Lawrence4U/Irrigation-System-v2/README.md

# Irrigation System using LoRa communications and Chirpstack

### KiCad

The external footprints used can be found in the [Imports](./KiCad/symbols/Imports/) folder.
