Lawrence4U/Irrigation-System-v2/misc/AnemYLuz.md

### Anemometros

+ Aliemntacion 7-24V. Salida de 0.4V(0m/s) a 2V (32.4m/s) con precision 1m/s [link](https://www.digikey.es/es/products/detail/adafruit-industries-llc/1733/5356813?productid=5356813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)

+ info solo que va de 0 a 5V [link](https://www.mouser.es/ProductDetail/DFRobot/SEN0170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)

+ el de sparkFun. Incluye anem, lluvia y dirección de viento pero complejo [link](https://www.mouser.es/ProductDetail/SparkFun/SEN-15901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)

### Sensores de luz

+ Placa de TEMT6000, podriamos montarlo nosotros en placa directo [link](https://www.digikey.es/es/products/detail/sparkfun-electronics/BOB-08688/5140813?productid=5140813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)

+ si lo montamos en la caja con la placa, i2c [link](https://www.digikey.es/es/products/detail/adafruit-industries-llc/5591/16733167?productid=16733167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)

+ Uno muy simplón con salida analógica [link](https://www.digikey.es/es/products/detail/adafruit-industries-llc/2748/5775538?productid=5775538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)

Casi todos los sensores de luz son un sensor montado en una placa por I2C

st1480 422 driver
