Lawrence4U/Irrigation-System-v2/KiCad/symbols/Imports/SimbolosSnapEDA/SOIC28-300.STEP

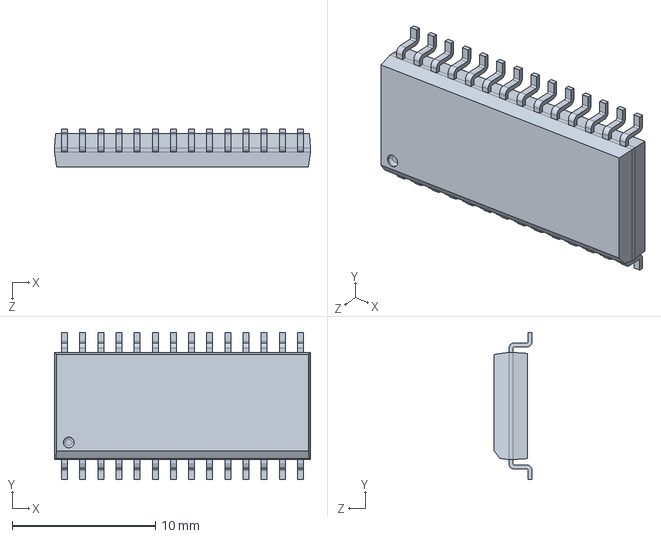
[picture p3: CAD file, 2024-04-19]
KiCad/symbols/Imports/SimbolosSnapEDA/SOIC28-300.STEP
17.9 x 10.3 x 2.65 mm
