Lawrence4U/Irrigation-System-v2/KiCad/symbols/Imports/SimbolosSnapEDA/L298P--3DModel-STEP-56544.STEP

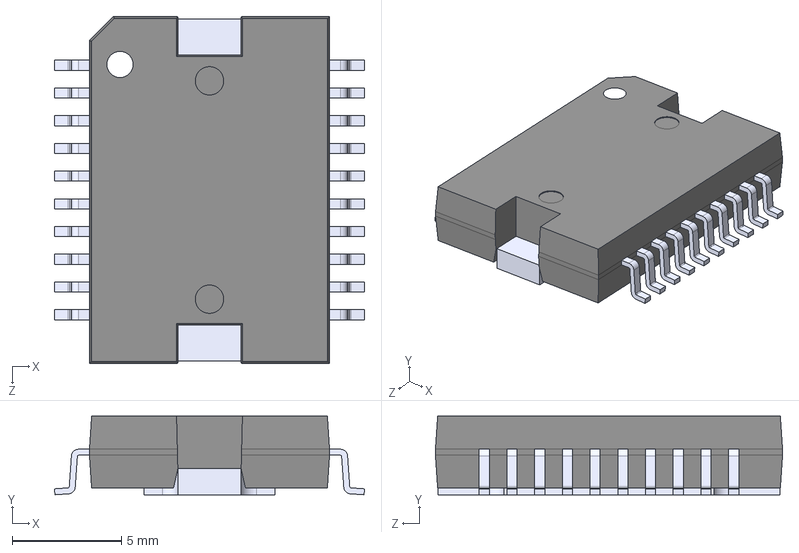
[picture p4: CAD file, 2024-04-19]
KiCad/symbols/Imports/SimbolosSnapEDA/L298P--3DModel-STEP-56544.STEP
14.2 x 3.60 x 15.9 mm
