Lawrence4U/Irrigation-System-v2/KiCad/symbols/Imports/SimbolosSnapEDA/DS89C21TMX_NOPB.STEP

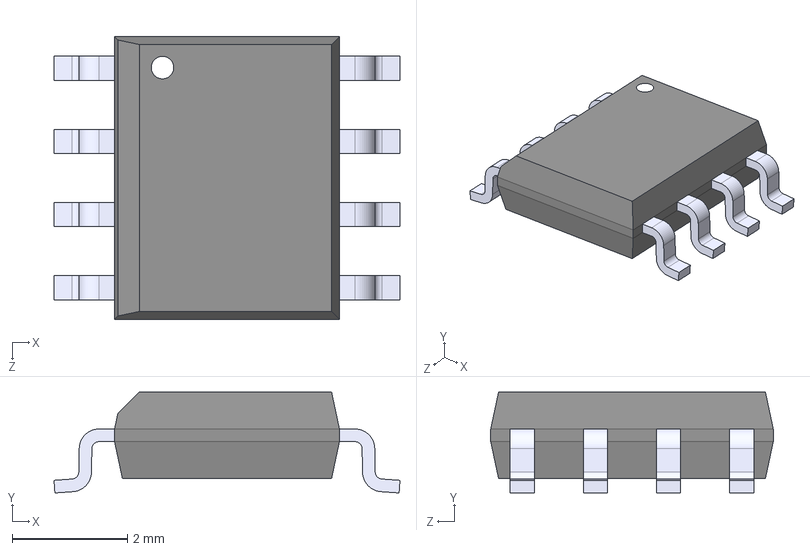
[picture p5: CAD file, 2024-04-16]
KiCad/symbols/Imports/SimbolosSnapEDA/DS89C21TMX_NOPB.STEP
6.00 x 1.75 x 4.90 mm
