Lawrence4U/Irrigation-System-v2/KiCad/symbols/Imports/SimbolosSnapEDA/TMP75AQDGKRQ1.STEP

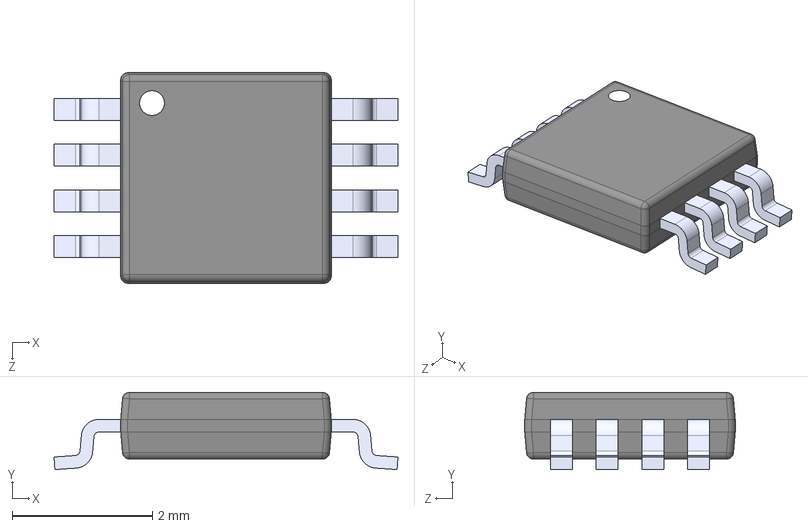
[picture p6: CAD file, 2024-04-16]
KiCad/symbols/Imports/SimbolosSnapEDA/TMP75AQDGKRQ1.STEP
4.90 x 1.10 x 3.00 mm
