Lawrence4U/Irrigation-System-v2/KiCad/3d/691382040006.stp

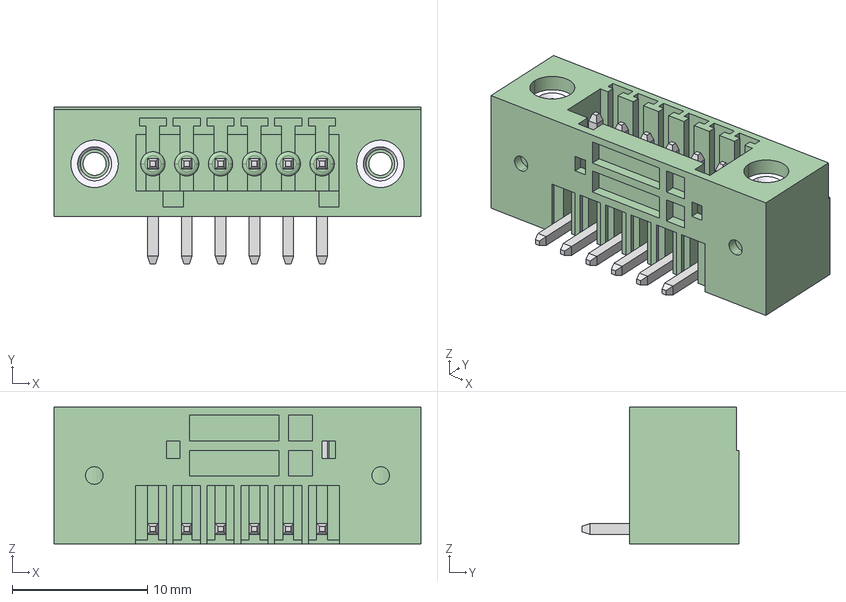
[picture p7: CAD file, 2024-02-01]
KiCad/3d/691382040006.stp
27.1 x 11.6 x 10.1 mm
