Lawrence4U/Irrigation-System-v2/KiCad/symbols/Imports/SimbolosSnapEDA/691382030006.step

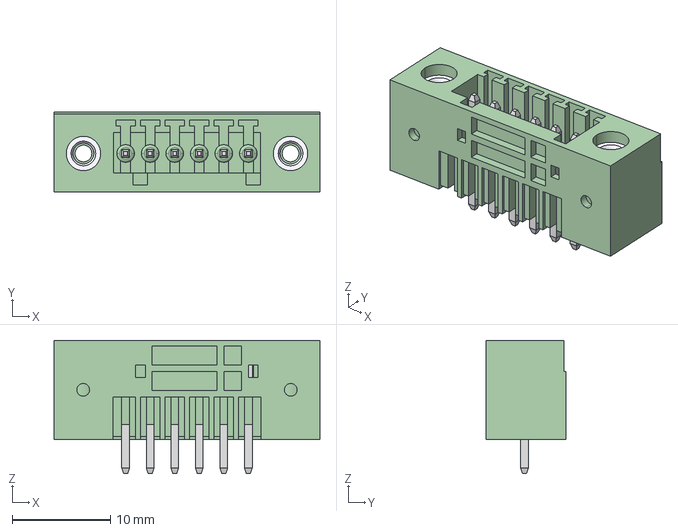
[picture p8: CAD file, 2024-02-10]
KiCad/symbols/Imports/SimbolosSnapEDA/691382030006.step
27.1 x 8.10 x 13.6 mm
