Lawrence4U/Irrigation-System-v2/KiCad/SalveNode/gerbers/SalveNode-F_Silkscreen.pdf

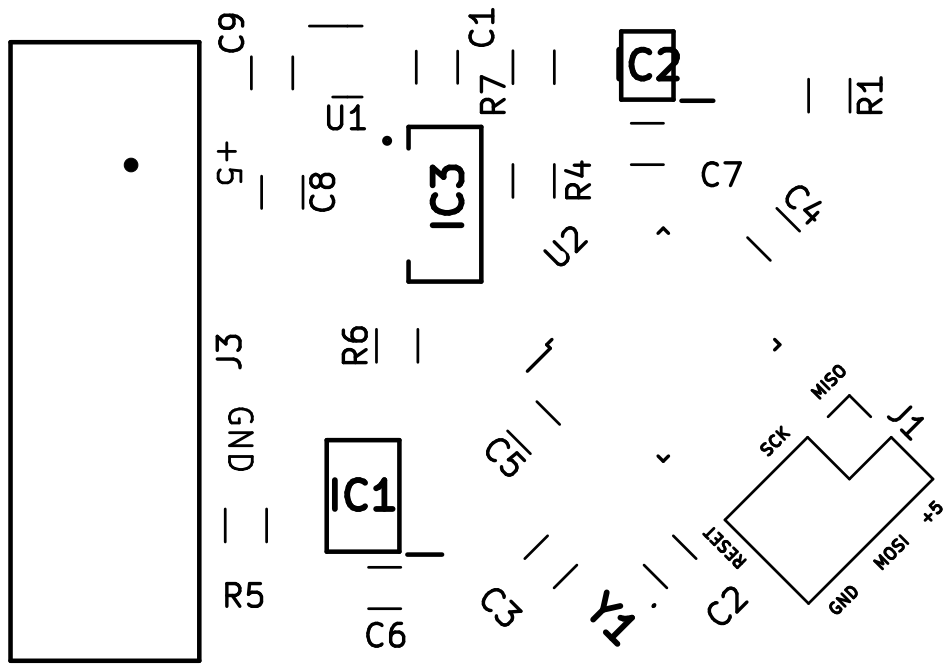
[picture p9: page 1]

SCK GND RESET MOSI +5 +5 GND MISO R5C9C1 J3 Y1 C7 C3 R1 C4 R7 C5 R4 IC2 U2 J1 C8 IC3 C6 U1
