Lawrence4U/Irrigation-System-v2/KiCad/SalveNode/gerbers/SalveNode-B_Cu.pdf

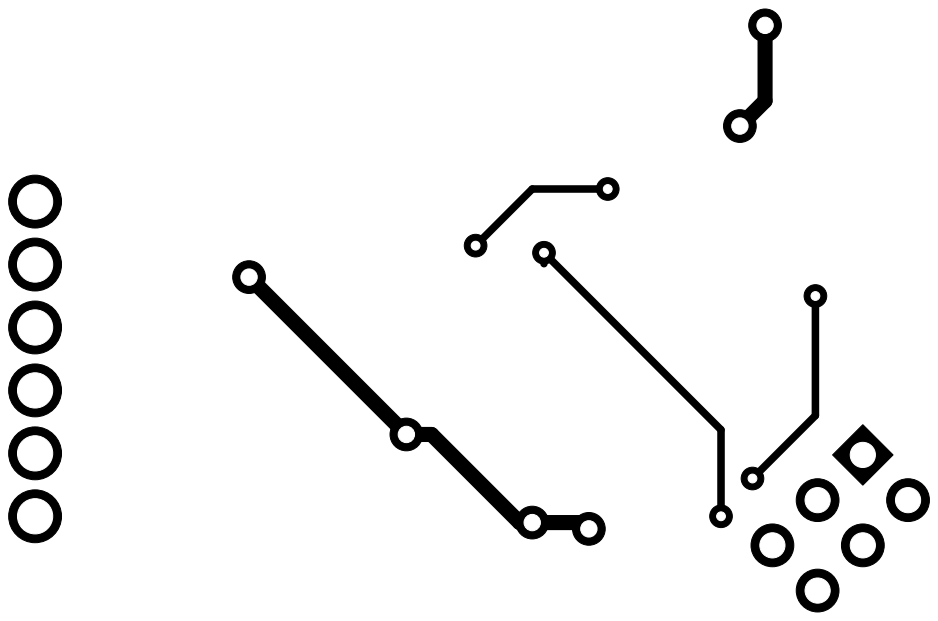
[picture p10: page 1]
