Lawrence4U/Irrigation-System-v2/KiCad/SalveNode/gerbers/SalveNode-B_Mask.pdf

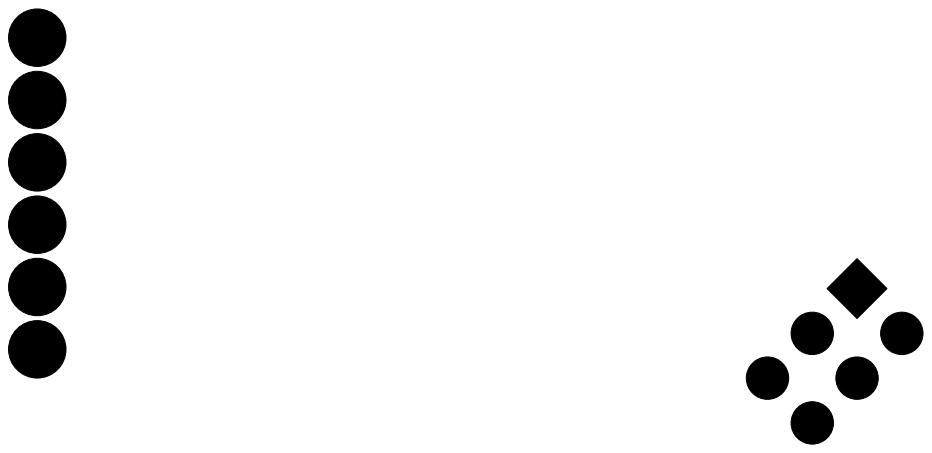
[picture p11: page 1]
