Lawrence4U/Irrigation-System-v2/KiCad/SalveNode/gerbers/SalveNode-F_Cu.pdf

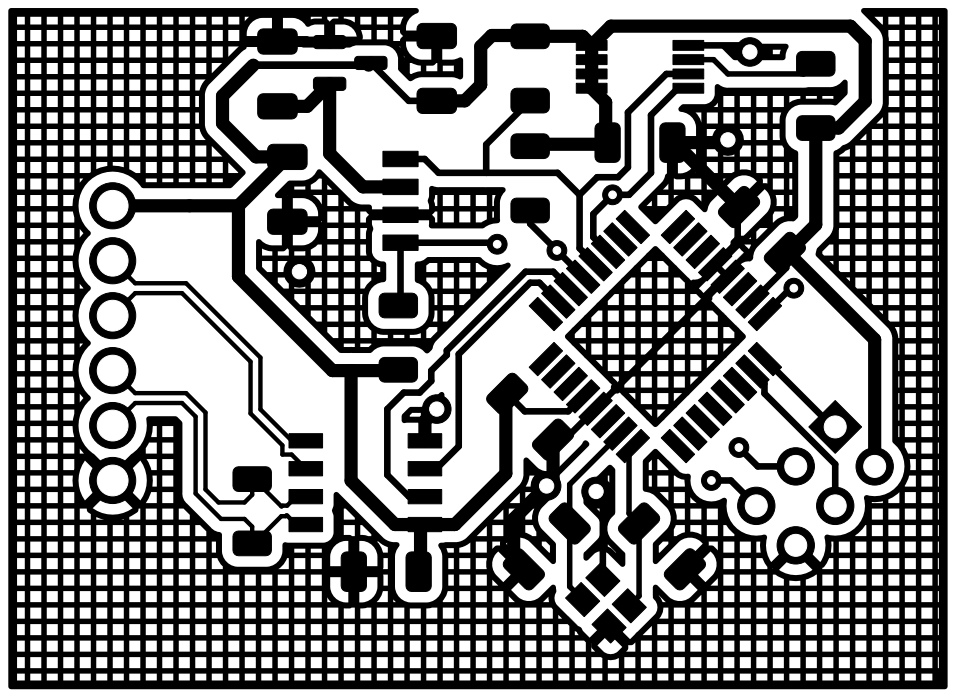
[picture p12: page 1]
