Lawrence4U/Irrigation-System-v2/KiCad/SalveNode/gerbers/SalveNode-F_Mask.pdf

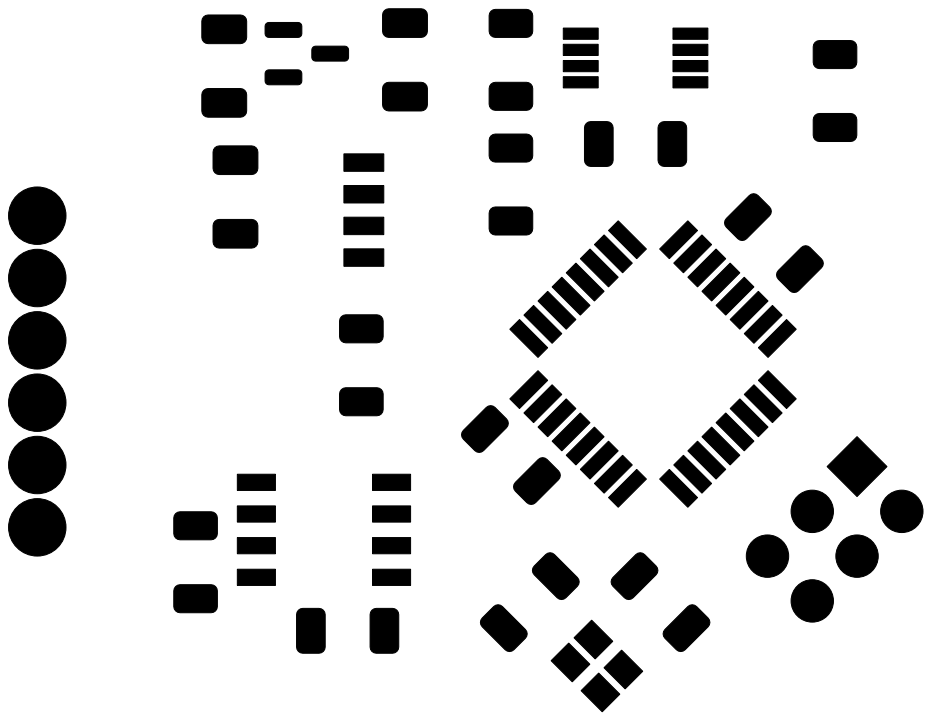
[picture p13: page 1]
