Lawrence4U/Irrigation-System-v2/KiCad/SalveNode/gerbers/SalveNode-F_Paste.pdf

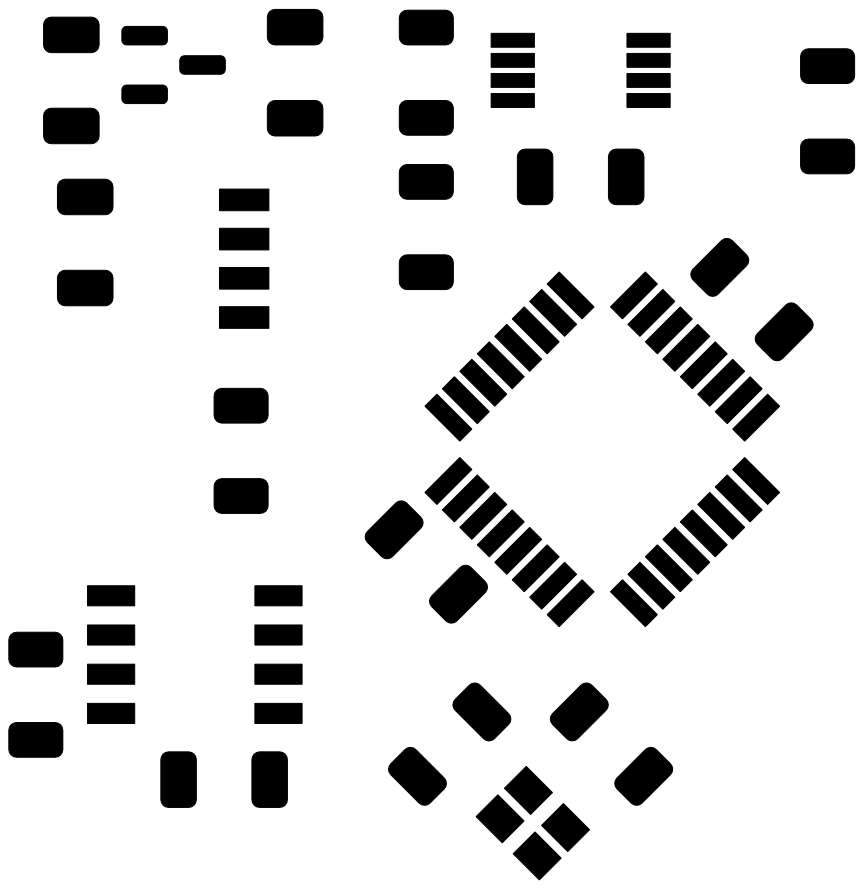
[picture p14: page 1]
