Lawrence4U/Irrigation-System-v2/KiCad/IrrigationController/KiCad.kicad_pcb

## KiCad design KiCad/IrrigationController/KiCad.kicad_pcb (2024-07-01)

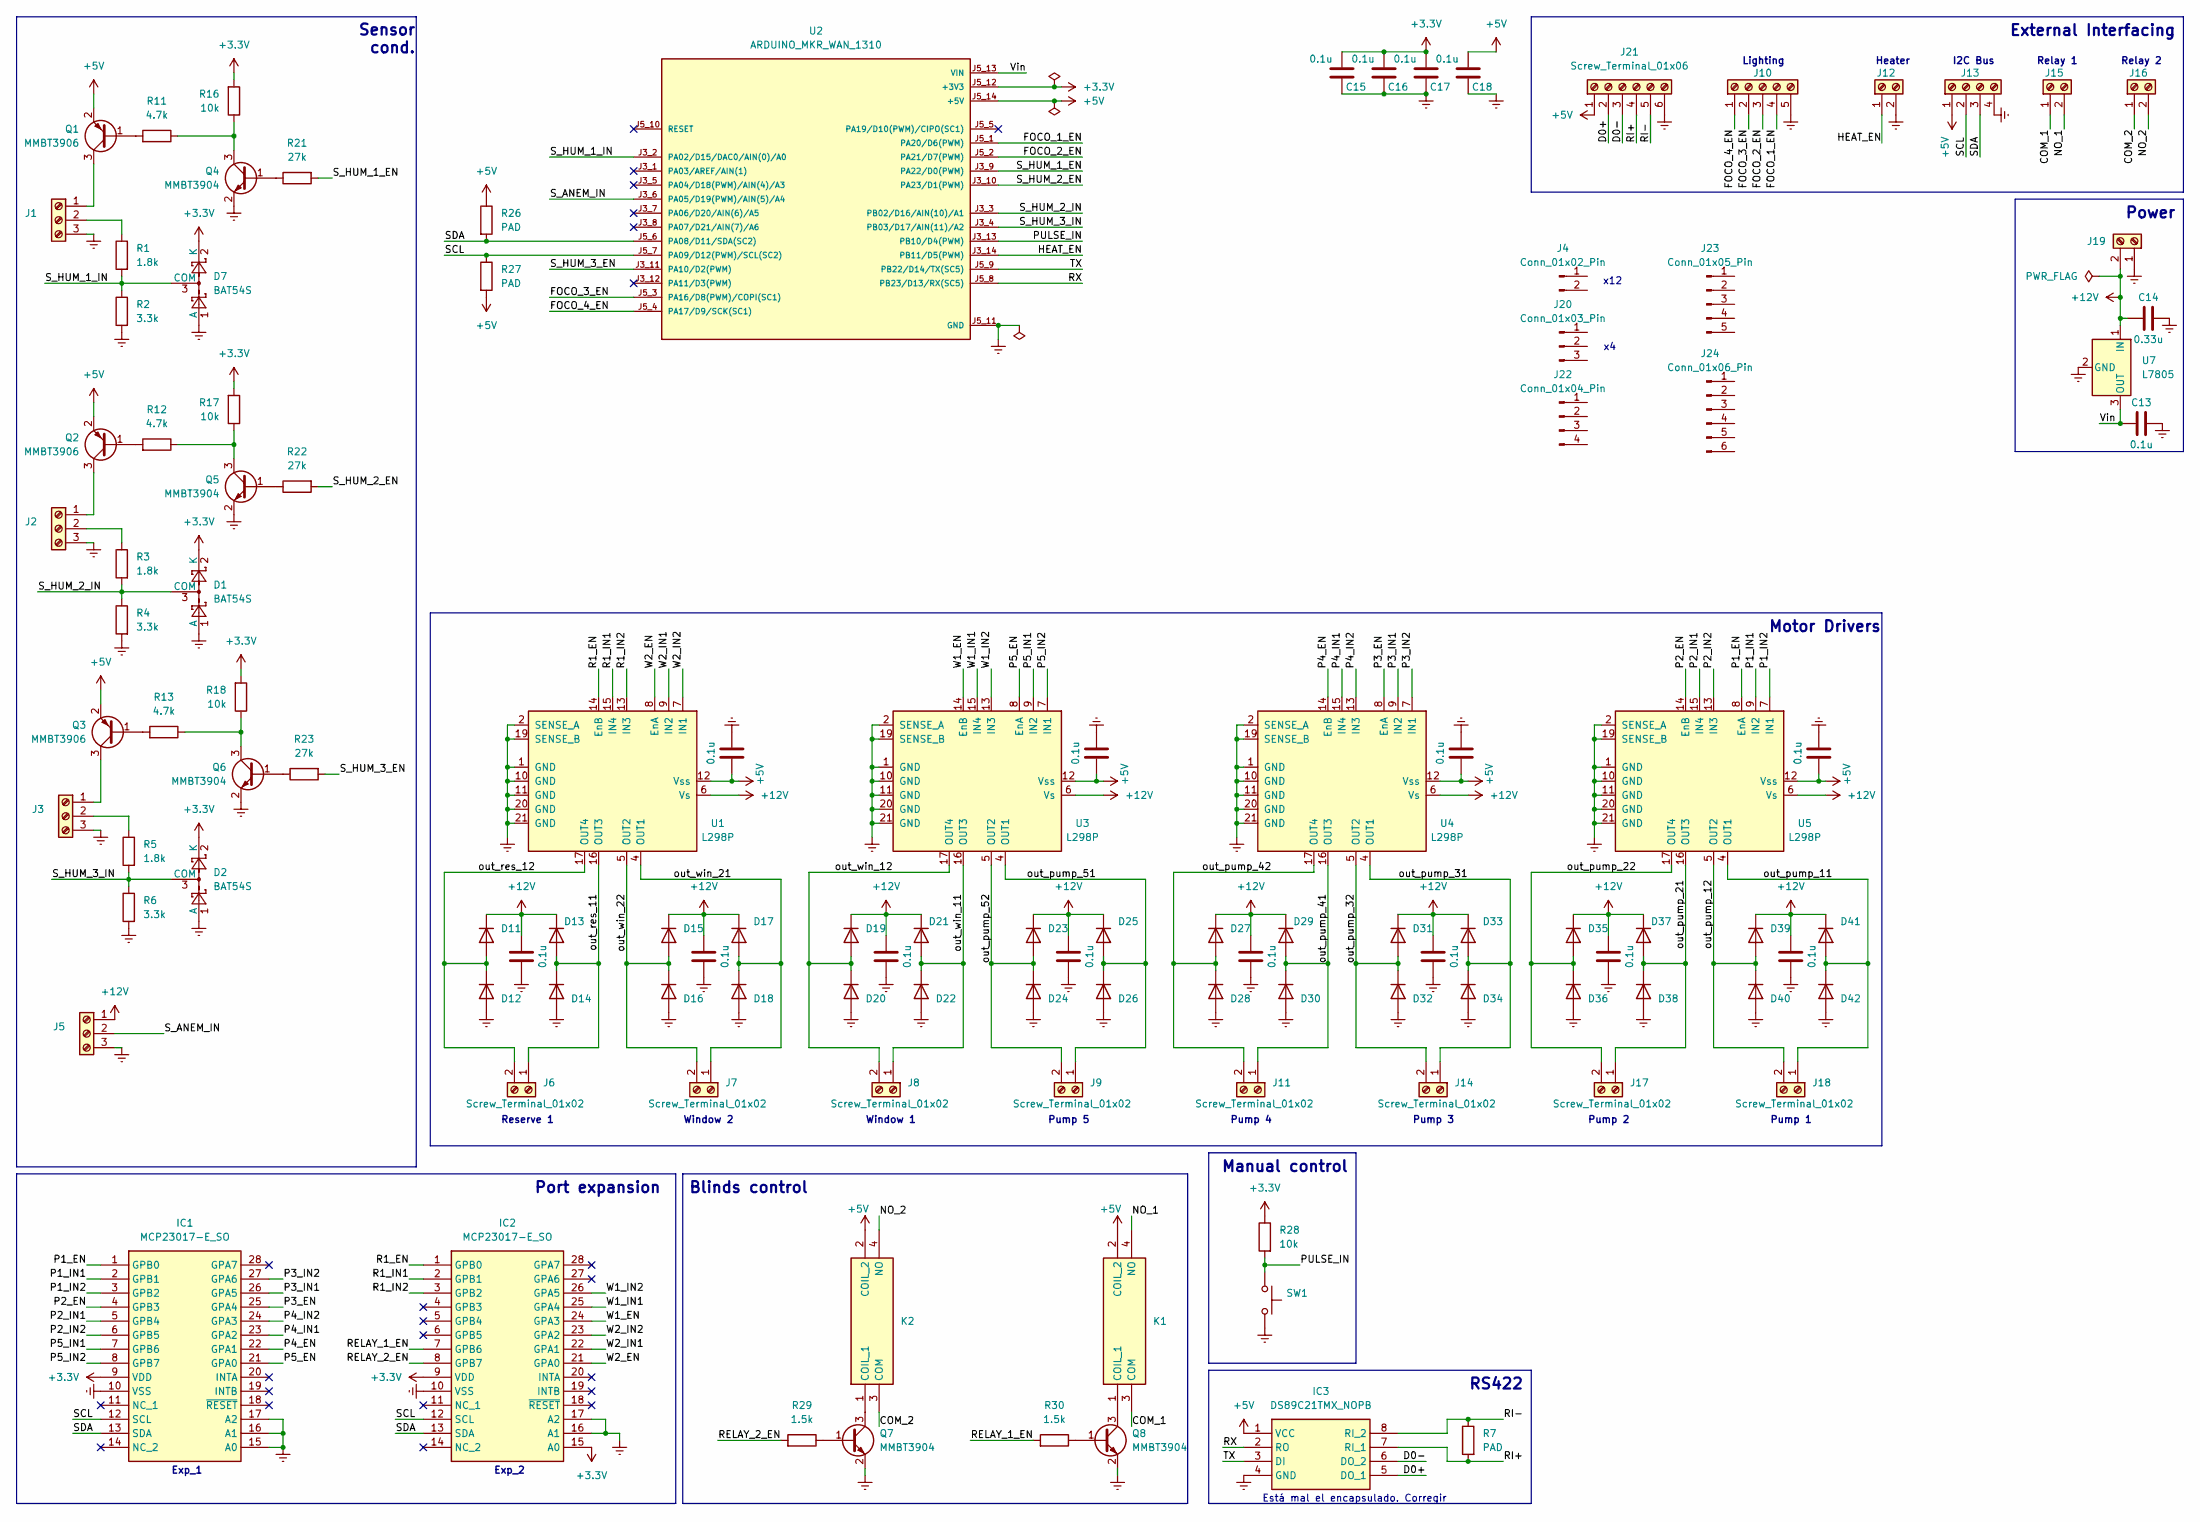
[picture p15: schematic KiCad.kicad_sch]

Parts:
C1, C2, C3, C4, C5, C6, C7, C8, C9, C10, C11, C12, C13, C15, C16, C17, C18: 0.1u; C_1206_3216Metric; Mouser Part Number 80-C1206X104K1RAUTO
C14: 0.33u; C_1206_3216Metric; Mouser Part Number 80-C1206X334K1RAUTO
D1, D2, D7: BAT54S; SOT-23; Mouser Part Number 637-BAT54S
D11, D12, D13, D14, D15, D16, D17, D18, D19, D20, D21, D22, D23, D24, D25, D26, D27, D28, D29, D30, D31, D32, D33, D34, D35, D36, D37, D38, D39, D40, D41, D42: SS24; D_SMB; Mouser Part Number 821-SS24
IC1, IC2: MCP23017-E_SO; SOIC127P1030X265-28N; Mouser Part Number 579-MCP23017-E/SO
IC3: DS89C21TMX_NOPB; SOIC127P600X175-8N; Mouser Part Number 926-DS89C21TMX/NOPB
J1, J2, J3, J5: Screw_Terminal_01x03; TerminalBlock_Phoenix_MKDS-1,5-3_1x03_P5.00mm_Horizontal; Mouser Part Number 710-691311700003
J4: Conn_01x02_Pin; Mouser Part Number 710-691352710002
J6, J7, J8, J9, J11, J12, J14, J15, J16, J17, J18, J19: Screw_Terminal_01x02; TerminalBlock_Phoenix_MKDS-1,5-2_1x02_P5.00mm_Horizontal; Mouser Part Number 710-691311700002
J10: Screw_Terminal_01x05; TerminalBlock_Phoenix_MKDS-1,5-5_1x05_P5.00mm_Horizontal; Mouser Part Number 710-691311700005
J13: Screw_Terminal_01x04; TerminalBlock_Phoenix_MKDS-1,5-4_1x04_P5.00mm_Horizontal; Mouser Part Number 710-691311700004
J20: Conn_01x03_Pin; Mouser Part Number 710-691352710003
J21: Screw_Terminal_01x06; TerminalBlock_Phoenix_MKDS-1,5-6_1x06_P5.00mm_Horizontal; Mouser Part Number 710-691311700006
J22: Conn_01x04_Pin; Mouser Part Number 710-691352710004
J23: Conn_01x05_Pin; Mouser Part Number 710-691352710005
J24: Conn_01x06_Pin; Mouser Part Number 710-691352710006
K1, K2: 2071556-9; 20715569; Mouser Part Number 655-2071556-9
Q1, Q2, Q3: MMBT3906; SOT-23
Q4, Q5, Q6, Q7, Q8: MMBT3904; SOT-23
R1, R3, R5: 1.8k; R_1206_3216Metric; Mouser Part Number 603-RT1206FRE071K8L
R2, R4, R6: 3.3k; R_1206_3216Metric; Mouser Part Number 603-RT1206FRE073K3L
R7, R26, R27: PAD; R_1206_3216Metric
R11, R12, R13: 4.7k; R_1206_3216Metric; Mouser Part Number 603-RT1206FRE074K7L
R16, R17, R18, R28: 10k; R_1206_3216Metric; Mouser Part Number 603-RT1206FRE1310KL
R21, R22, R23: 27k; R_1206_3216Metric; Mouser Part Number 603-RT1206FRE0727KL
R29, R30: 1.5k; R_1206_3216Metric; Mouser Part Number 603-RT1206FRE071K5L
SW1: SW_Push; SW_PUSH_6mm_H4.3mm
U1, U3, U4, U5: L298P; HSOP-20-1EP_11.0x15.9mm_P1.27mm_SlugDown_ThermalVias; Mouser Part Number 511-L298P
U2: ARDUINO_MKR_WAN_1310; BOARD_ARDUINO_MKR_WAN_1310; PARTREV 06/27/2019
U7: L7805; TO-263-2; Mouser Part Number 511-L7805ABD2T-TR

Connections:
+5V: C3.1, C6.1, C9.1, C12.1, C18.1, IC3.1 (VCC), J13.1, J21.1, K1.2 (COIL_2), K2.2 (COIL_2), Q1.2 (E), Q2.2 (E), Q3.2 (E), R26.1, R27.2, U1.12 (Vss), U2.J5_14 (+5V), U3.12 (Vss), U4.12 (Vss), U5.12 (Vss)
+12V: C1.1, C2.1, C4.1, C5.1, C7.1, C8.1, C10.1, C11.1, C14.1, D11.1 (K), D13.1 (K), D15.1 (K), D17.1 (K), D19.1 (K), D21.1 (K), D23.1 (K), D25.1 (K), D27.1 (K), D29.1 (K), D31.1 (K), D33.1 (K), D35.1 (K), D37.1 (K), D39.1 (K), D41.1 (K), J5.1, J19.2, U1.6 (Vs), U3.6 (Vs), U4.6 (Vs), U5.6 (Vs), U7.1 (IN)
/COM_1: J15.1, K1.3 (COM)
/COM_2: J16.1, K2.3 (COM)
/D0+: IC3.5 (DO_1), J21.2
/D0-: IC3.6 (DO_2), J21.3
/FOCO_1_EN: J10.4, U2.J5_1 (PA20/D6(PWM))
/FOCO_2_EN: J10.3, U2.J5_2 (PA21/D7(PWM))
/FOCO_3_EN: J10.2, U2.J5_3 (PA16/D8(PWM)/COPI(SC1))
/FOCO_4_EN: J10.1, U2.J5_4 (PA17/D9/SCK(SC1))
/HEAT_EN: J12.1, U2.J3_14 (PB11/D5(PWM))
/NO_1: J15.2, K1.4 (NO)
/NO_2: J16.2, K2.4 (NO)
/P1_EN: IC1.1 (GPB0), U5.8 (EnA)
/P1_IN1: IC1.2 (GPB1), U5.9 (IN2)
/P1_IN2: IC1.3 (GPB2), U5.7 (IN1)
/P2_EN: IC1.4 (GPB3), U5.14 (EnB)
/P2_IN1: IC1.5 (GPB4), U5.15 (IN4)
/P2_IN2: IC1.6 (GPB5), U5.13 (IN3)
/P3_EN: IC1.25 (GPA4), U4.8 (EnA)
/P3_IN1: IC1.26 (GPA5), U4.9 (IN2)
/P3_IN2: IC1.27 (GPA6), U4.7 (IN1)
/P4_EN: IC1.22 (GPA1), U4.14 (EnB)
/P4_IN1: IC1.23 (GPA2), U4.15 (IN4)
/P4_IN2: IC1.24 (GPA3), U4.13 (IN3)
/P5_EN: IC1.21 (GPA0), U3.8 (EnA)
/P5_IN1: IC1.7 (GPB6), U3.9 (IN2)
/P5_IN2: IC1.8 (GPB7), U3.7 (IN1)
/PULSE_IN: R28.2, SW1.1, U2.J3_13 (PB10/D4(PWM))
/R1_EN: IC2.1 (GPB0), U1.14 (EnB)
/R1_IN1: IC2.2 (GPB1), U1.15 (IN4)
/R1_IN2: IC2.3 (GPB2), U1.13 (IN3)
/RELAY_1_EN: IC2.7 (GPB6), R30.2
/RELAY_2_EN: IC2.8 (GPB7), R29.2
/RI+: IC3.7 (RI_1), J21.4, R7.2
/RI-: IC3.8 (RI_2), J21.5, R7.1
/RX: IC3.2 (RO), U2.J5_8 (PB23/D13/RX(SC5))
/SCL: IC1.12 (SCL), IC2.12 (SCL), J13.2, R27.1, U2.J5_7 (PA09/D12(PWM)/SCL(SC2))
/SDA: IC1.13 (SDA), IC2.13 (SDA), J13.3, R26.2, U2.J5_6 (PA08/D11/SDA(SC2))
/S_ANEM_IN: J5.2, U2.J3_6 (PA05/D19(PWM)/AIN(5)/A4)
/S_HUM_1_EN: R21.2, U2.J3_9 (PA22/D0(PWM))
/S_HUM_1_IN: D7.3 (COM), R1.2, R2.1, U2.J3_2 (PA02/D15/DAC0/AIN(0)/A0)
/S_HUM_2_EN: R22.2, U2.J3_10 (PA23/D1(PWM))
/S_HUM_2_IN: D1.3 (COM), R3.2, R4.1, U2.J3_3 (PB02/D16/AIN(10)/A1)
/S_HUM_3_EN: R23.2, U2.J3_11 (PA10/D2(PWM))
/S_HUM_3_IN: D2.3 (COM), R5.2, R6.1, U2.J3_4 (PB03/D17/AIN(11)/A2)
/TX: IC3.3 (DI), U2.J5_9 (PB22/D14/TX(SC5))
/W1_EN: IC2.24 (GPA3), U3.14 (EnB)
/W1_IN1: IC2.25 (GPA4), U3.15 (IN4)
/W1_IN2: IC2.26 (GPA5), U3.13 (IN3)
/W2_EN: IC2.21 (GPA0), U1.8 (EnA)
/W2_IN1: IC2.22 (GPA1), U1.9 (IN2)
/W2_IN2: IC2.23 (GPA2), U1.7 (IN1)
/out_pump_11: D41.2 (A), D42.1 (K), J18.1, U5.4 (OUT1)
/out_pump_12: D39.2 (A), D40.1 (K), J18.2, U5.5 (OUT2)
/out_pump_21: D37.2 (A), D38.1 (K), J17.1, U5.16 (OUT3)
/out_pump_22: D35.2 (A), D36.1 (K), J17.2, U5.17 (OUT4)
/out_pump_31: D33.2 (A), D34.1 (K), J14.1, U4.4 (OUT1)
/out_pump_32: D31.2 (A), D32.1 (K), J14.2, U4.5 (OUT2)
/out_pump_41: D29.2 (A), D30.1 (K), J11.1, U4.16 (OUT3)
/out_pump_42: D27.2 (A), D28.1 (K), J11.2, U4.17 (OUT4)
/out_pump_51: D25.2 (A), D26.1 (K), J9.1, U3.4 (OUT1)
/out_pump_52: D23.2 (A), D24.1 (K), J9.2, U3.5 (OUT2)
/out_res_11: D13.2 (A), D14.1 (K), J6.1, U1.16 (OUT3)
/out_res_12: D11.2 (A), D12.1 (K), J6.2, U1.17 (OUT4)
/out_win_11: D21.2 (A), D22.1 (K), J8.1, U3.16 (OUT3)
/out_win_12: D19.2 (A), D20.1 (K), J8.2, U3.17 (OUT4)
/out_win_21: D17.2 (A), D18.1 (K), J7.1, U1.4 (OUT1)
/out_win_22: D15.2 (A), D16.1 (K), J7.2, U1.5 (OUT2)
unnamed: J1.1, Q1.3 (C)
unnamed: J1.2, R1.1
unnamed: J2.1, Q2.3 (C)
unnamed: J2.2, R3.1
unnamed: J3.1, Q3.3 (C)
unnamed: J3.2, R5.1
unnamed: K1.1 (COIL_1), Q8.3 (C)
unnamed: K2.1 (COIL_1), Q7.3 (C)
unnamed: Q1.1 (B), R11.2
unnamed: Q2.1 (B), R12.2
unnamed: Q3.1 (B), R13.2
unnamed: Q4.1 (B), R21.1
unnamed: Q4.3 (C), R11.1, R16.1
unnamed: Q5.1 (B), R22.1
unnamed: Q5.3 (C), R12.1, R17.1
unnamed: Q6.1 (B), R23.1
unnamed: Q6.3 (C), R13.1, R18.1
unnamed: Q7.1 (B), R29.1
unnamed: Q8.1 (B), R30.1

Notes on the sheet:
Sensor cond.
Window 1
RS422
Lighting
I2C Bus
Pump 4
x12
Pump 3
Manual control
Heater
Pump 5
Reserve 1
Blinds control
Window 2
Exp_2
Relay 1
Pump 2
External Interfacing
Relay 2
Exp_1
Power
Pump 1
Motor Drivers
Port expansion
Está mal el encapsulado. Corregir

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
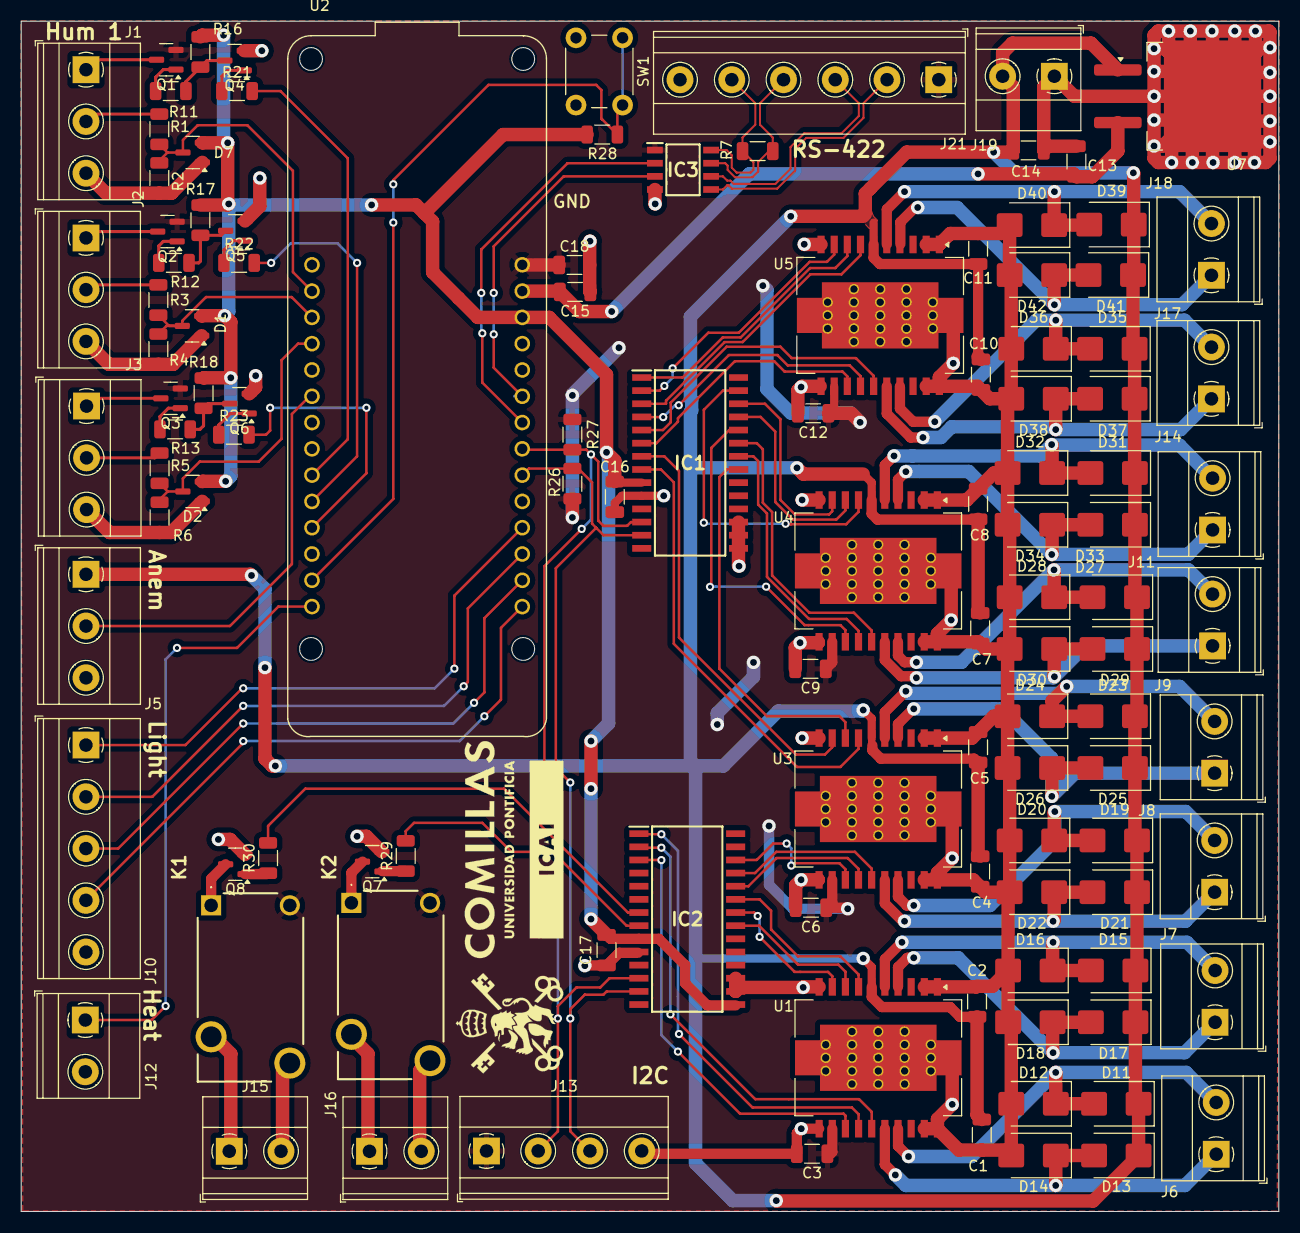
[picture p16: board KiCad.kicad_pcb from above]

Board: 2 copper layers, 121.5 x 115.0 mm, 113 parts (0 on the bottom side), 91 nets.
