Lawrence4U/Irrigation-System-v2/KiCad/SalveNode/SalveNode.kicad_pcb

## KiCad design KiCad/SalveNode/SalveNode.kicad_pcb (2024-06-18)

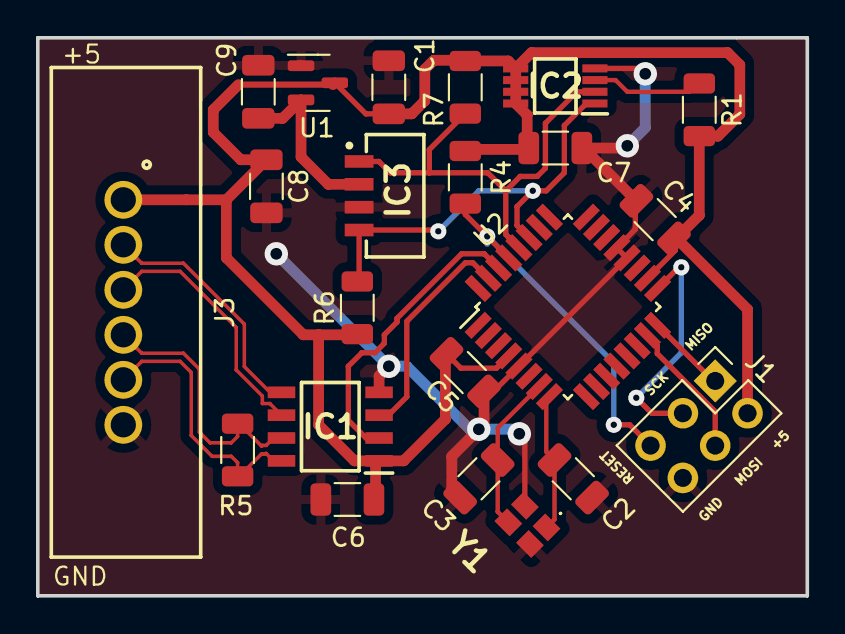
[picture p17: board SalveNode.kicad_pcb from above]

Board: 2 copper layers, 42.8 x 31.0 mm, 22 parts (0 on the bottom side), 17 nets.

Parts:
C1, C9: 1u; C_1206_3216Metric
C2, C3: 12p; C_1206_3216Metric
C4, C5, C6, C7, C8: 100n; C_1206_3216Metric
IC1: DS89C21TMX_NOPB; SOIC127P600X175-8N
IC2: TMP75AQDGKRQ1; SOP65P490X110-8N
IC3: VEML7700-TR; VEML7700
J1: AVR-ISP-6; PinHeader_2x03_P2.54mm_Vertical
J3: 691382030006
R1: 5k; R_1206_3216Metric
R4: 10k; R_1206_3216Metric
R5: PAD; R_1206_3216Metric
R6, R7: 4.7k; R_1206_3216Metric
U1: MCP1700x-330xxTT; SOT-23
U2: ATmega328PB-A; TQFP-32_7x7mm_P0.8mm
Y1: 16M; ECS1601036CKMTR3

Connections:
+3.3V: C9.2, IC3.2 (VDD), U1.2 (VO)
+5V: C1.2, C4.2, C5.2, C6.2, C7.2, C8.2, IC1.1 (VCC), IC2.5 (A2), IC2.6 (A1), IC2.7 (A0), IC2.8 (V+), J1.2 (VCC), J3.1, R1.2, R4.2, R6.1, R7.2, U1.3 (VI), U2.4 (VCC), U2.18 (AVCC)
/D0+: IC1.6 (DO_2), J3.3
/D0-: IC1.5 (DO_1), J3.2
/MISO: J1.1 (MISO), U2.16 (PB4)
/MOSI: J1.4 (MOSI), U2.15 (PB3)
/RESET: J1.5 (~RST), R4.1, U2.29 (~RESET/PC6)
/RI+: IC1.8 (RI_2), J3.5, R5.1
/RI-: IC1.7 (RI_1), J3.4, R5.2
/RX: IC1.2 (RO), U2.30 (PD0)
/SCK: J1.3 (SCK), U2.17 (PB5)
/SCL: IC2.2 (SCL), IC3.1 (SCL), R7.1, U2.28 (PC5)
/SDA: IC2.1 (SDA), IC3.4 (SDA), R6.2, U2.27 (PC4)
/TX: IC1.3 (DI), U2.31 (PD1)
/XTAL1: C3.2, U2.7 (XTAL1/PB6), Y1.3
/XTAL2: C2.2, U2.8 (XTAL2/PB7), Y1.1
Earth: C1.1, C2.1, C3.1, C4.1, C5.1, C6.1, C7.1, C8.1, C9.1, IC1.4 (GND), IC2.4 (GND), IC3.3 (GND), J1.6 (GND), J3.6, U1.1 (GND), U2.5 (GND), U2.20 (AREF), U2.21 (GND), Y1.2, Y1.4
