Lawrence4U/Irrigation-System-v2/(commit log)

2023-09-17 Added kicad files
    [KiCad.kicad_pcb, KiCad.kicad_sch]
2023-09-30 imp kicad
    [KiCad.kicad_sch]
2023-10-04 more kicad
    [KiCad.kicad_sch]
2023-10-06 addded Arduino files with definitions
    [KiCad.kicad_sch]
2023-10-09 sch done
    [KiCad.kicad_pcb, KiCad.kicad_sch]
2023-10-28 kicad sch finalised
    [KiCad.kicad_sch]
2023-10-30 added missing footprints
    [KiCad.kicad_pcb, KiCad.kicad_sch]
2023-11-08 seleccion de anemometros y sensores de luz
2023-11-20 sch cahnges
    [KiCad.kicad_sch]
2023-11-21 added other sch
    [KiCad.kicad_pcb, KiCad.kicad_sch, SalveNode.kicad_pcb, SalveNode.kicad_sch]
2023-11-21 fixed err
    [KiCad.kicad_sch]
2023-11-24 tarjeta externa añadido
    [KiCad.kicad_sch, SalveNode.kicad_sch]
2023-11-24 sch complete
    [SalveNode.kicad_pcb, SalveNode.kicad_sch]
2023-12-04 pcb changes
    [SalveNode.kicad_pcb, SalveNode.kicad_sch]
2023-12-16 PCB Complete
    [SalveNode.kicad_pcb, SalveNode.kicad_sch]
2023-12-28 fixed missing R for reset while programming
    [SalveNode.kicad_pcb, SalveNode.kicad_sch]
2024-01-05 Created Arduino Files for Node + fixed missing pullup resistor for ALERT pin in tmp75
    [SalveNode.kicad_pcb, SalveNode.kicad_sch]
2024-02-01 BOM and PCB updated
    [691382040006.stp, SalveNode.csv, SalveNode.kicad_pcb, SalveNode.kicad_sch]
2024-02-02 fixes 2
    [SalveNode.csv, SalveNode.kicad_sch, SalveNodev3.csv, SalveNodev4.csv, SalveNodev5.csv]
2024-02-29 pcb fix
    [SalveNode.kicad_pcb]
2024-04-19 PCB created
    [KiCad.kicad_pcb, KiCad.kicad_sch, L298P--3DModel-STEP-56544.STEP, SOIC28-300.STEP]
2024-04-20 L298 as Power
    [KiCad.kicad_pcb, KiCad.kicad_sch]
2024-04-27 tracing in controller
    [KiCad.kicad_pcb, KiCad.kicad_sch]
2024-04-29 pcb rev1
    [KiCad.kicad_pcb, KiCad.kicad_sch]
2024-05-26 pcb donde
    [KiCad.kicad_pcb]
2024-05-27 Arregladas las conexiones al plano de masa
    [KiCad.kicad_pcb, KiCad.kicad_sch]
2024-06-16 started Arduino dev
2024-06-16 connected sensor structs + processing
2024-06-18 Añadidos los terminales a tornillo y generado el BOM
    [BOM_definitivo.csv, KiCad.csv, KiCad.kicad_sch]
2024-06-18 modified schematics and continued development of Arduino programs
    [SalveNode.kicad_pcb, SalveNode.kicad_sch]
2024-06-19 fixed last minute error on PCB + continued Arduino development
    [KiCad.kicad_pcb, KiCad.kicad_sch]
2024-06-25 Añadido comentario: está mal el encapsulado de IC3
    [BOM_definitivo.csv, KiCad.kicad_sch]
2024-06-26 Añadido C15 al esquema, que se había esfumado
    [KiCad.kicad_sch]
2024-06-26 keeping going
    [qwer.csv]
2024-06-28 fixed error on I2C lines
    [KiCad.kicad_pcb, KiCad.kicad_sch]
2024-07-01 Fixed remaining mistakes | wrong transistor + rs422 footprints
    [KiCad.kicad_pcb, KiCad.kicad_sch]
